LetSat/CarrierBoard_V2/092518_CARRIERV2.PNG

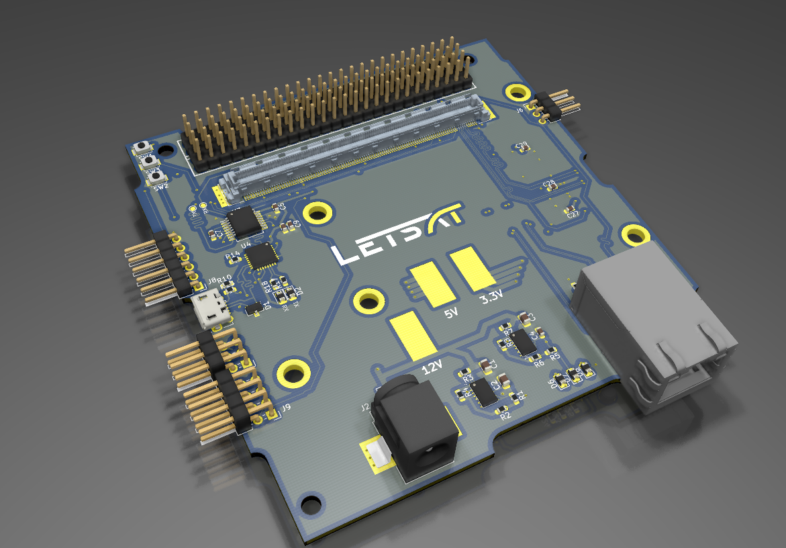
092518_CARRIERV2.PNG
