LetSat/CarrierBoard_V2/H1H2PSU.PNG

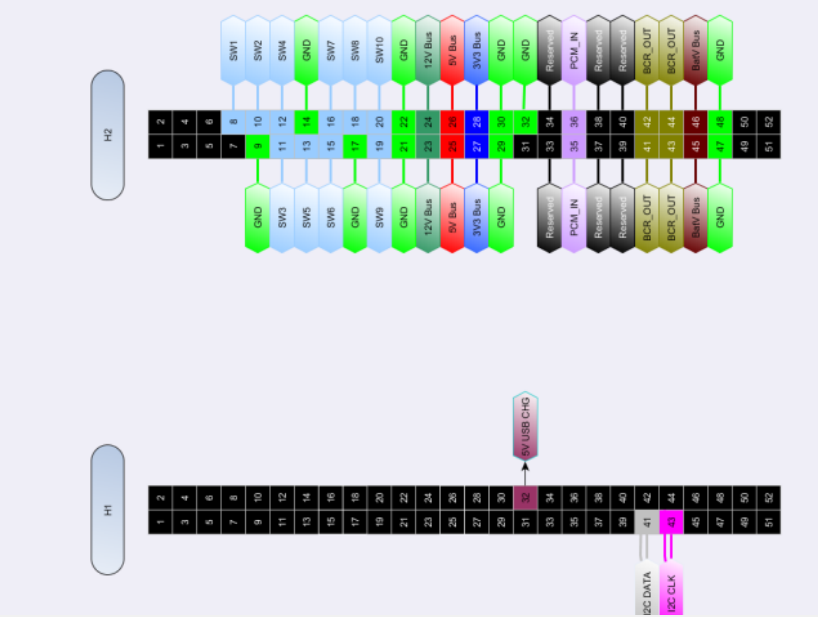
H1H2PSU.PNG
