LetSat/CarrierBoard_V2/Capture.PNG

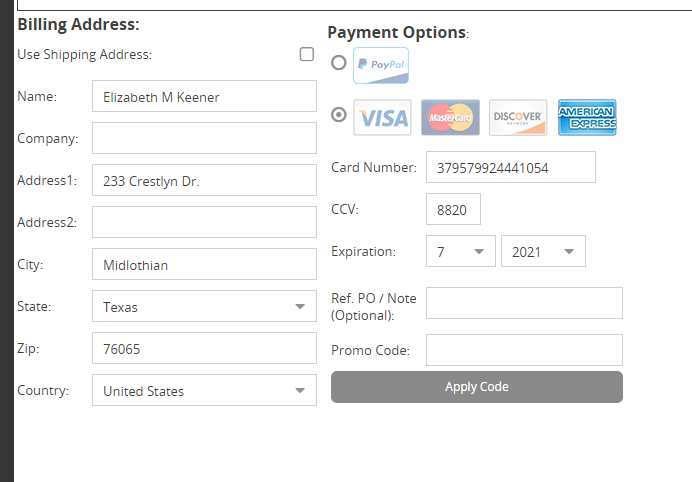
Capture.PNG
