LetSat/CarrierBoard_V2/H1H2FC.PNG

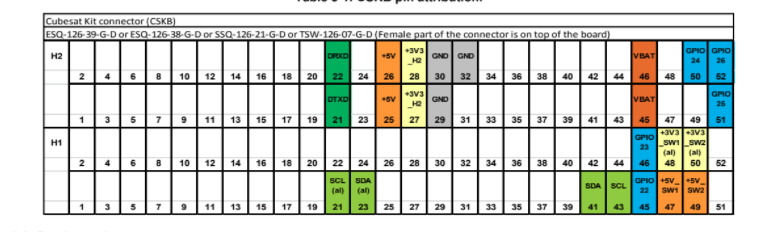
H1H2FC.PNG
