LetSat/CarrierBoard_V2/H1H2MAGT.PNG

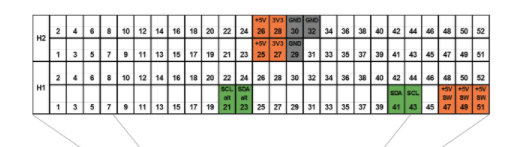
H1H2MAGT.PNG
