LetSat/CarrierBoard_V2/SPIBUSMcom.PNG

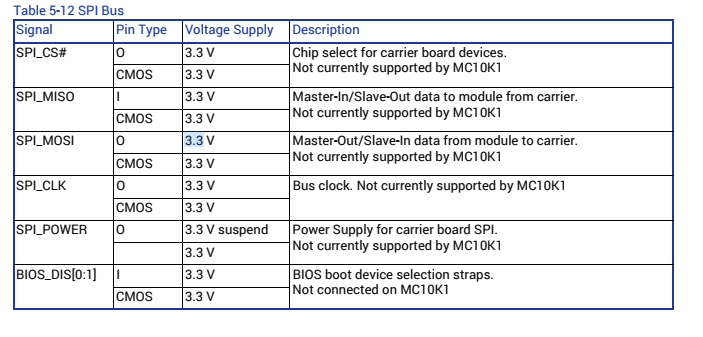
SPIBUSMcom.PNG
