LetSat/CarrierBoard_V2/Cart_Feb05_1015AM.xls

SHOPPING CART
This is not an invoice
05-Feb-18 10:15:46
 | Mouser # | Mfr. # | Manufacturer | Customer # | Description | RoHS | Lifecycle | Order Qty. | Price (USD) | Ext.: (USD)
1 | 530-SI-51009-F | SI-51009-F | Bel |  | Modular Connectors / Ethernet Connectors RJ45 Connector | RoHS Compliant |  | 1 | $5.70 | $5.70
2 | 755-BD67929EFV-E2 | BD67929EFV-E2 | ROHM Semiconductor |  | Motor / Motion / Ignition Controllers & Drivers NPN+NPN Driver Transistor | RoHS Compliant |  | 2 | $2.98 | $5.96
3 | 710-9774010151R | 9774010151R | Wurth Electronics |  | Standoffs & Spacers WA-SMSI SMT Steel M2.5 Intrnl NonStop | RoHS Compliant |  | 12 | $1.03 | $12.36
4 | 534-24380 | 24380 | Keystone Electronics |  | Standoffs & Spacers 4.5 HEX 5.0mm BRS | RoHS Compliant |  | 10 | $0.43 | $4.30
5 | 534-24381 | 24381 | Keystone Electronics |  | Standoffs & Spacers 4.5 HEX 6.0mm BRS | RoHS Compliant |  | 10 | $0.37 | $3.70
By submitting your order you agree to these terms and conditions. (https://www.mouser.com/saleterms) |  |  |  |  |  |  |  |  | Merchandise Total: | $32.02
Prices are reflected at the date and time shown. |  |  |  |  |  |  |  |  | Shipping Charge: | Estimate
 |  |  |  |  |  |  |  |  | Backorder Shipping: | Estimate
