LetSat/CarrierBoard_V2/CUI_PJ-036AH-SMT-TR.step

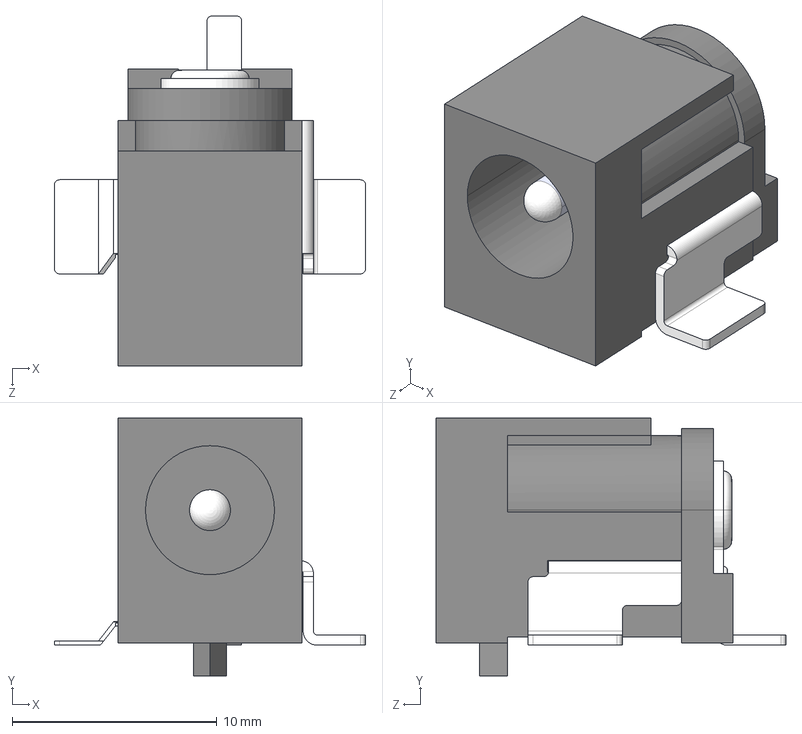
[picture p7: CAD file, 2018-09-25]
CUI_PJ-036AH-SMT-TR.step
15.2 x 12.6 x 17.1 mm
