LetSat/CarrierBoard_V2/ARJE-0034.STEP

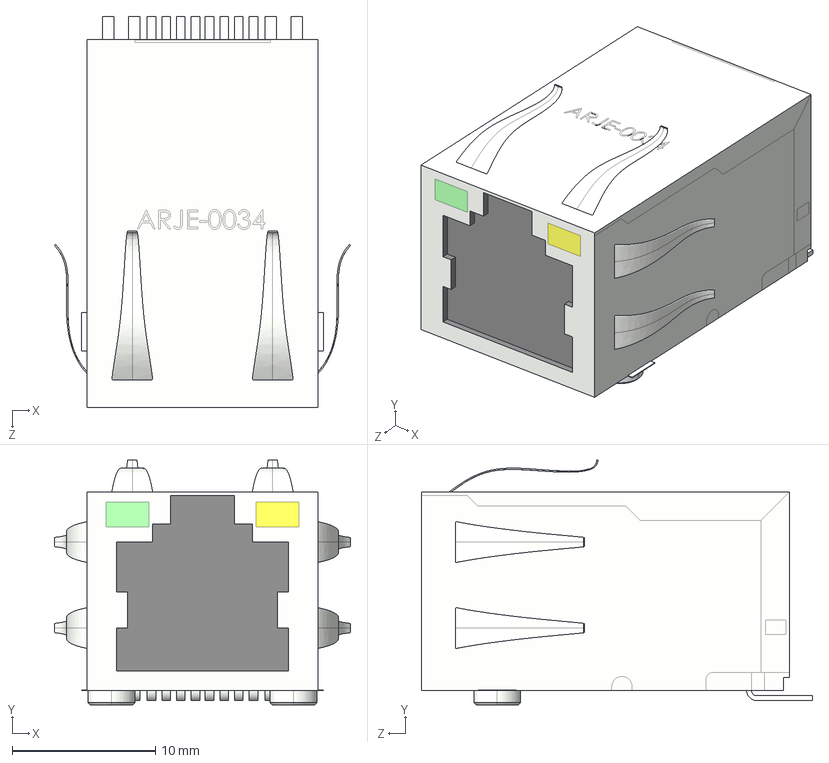
[picture p8: CAD file, 2018-09-25]
ARJE-0034.STEP
20.7 x 17.1 x 27.3 mm
