LetSat/CarrierBoard_V2/Carrier-Board.step

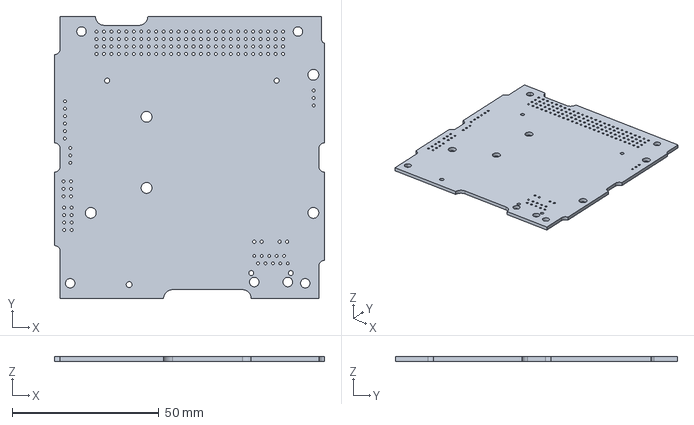
[picture p9: CAD file, 2018-09-14]
Carrier-Board.step
92.0 x 96.0 x 1.60 mm
