LetSat/CarrierBoard_V2/Part1.DXF

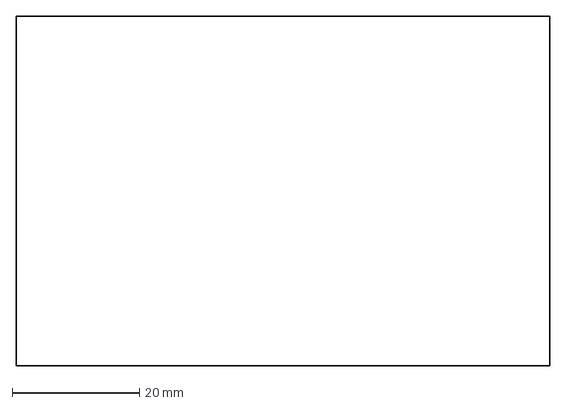
[picture p10: CAD file, 2018-09-14]
Part1.DXF
84.0 x 55.0 mm
