LetSat/CarrierBoard_V2/480251190.stp

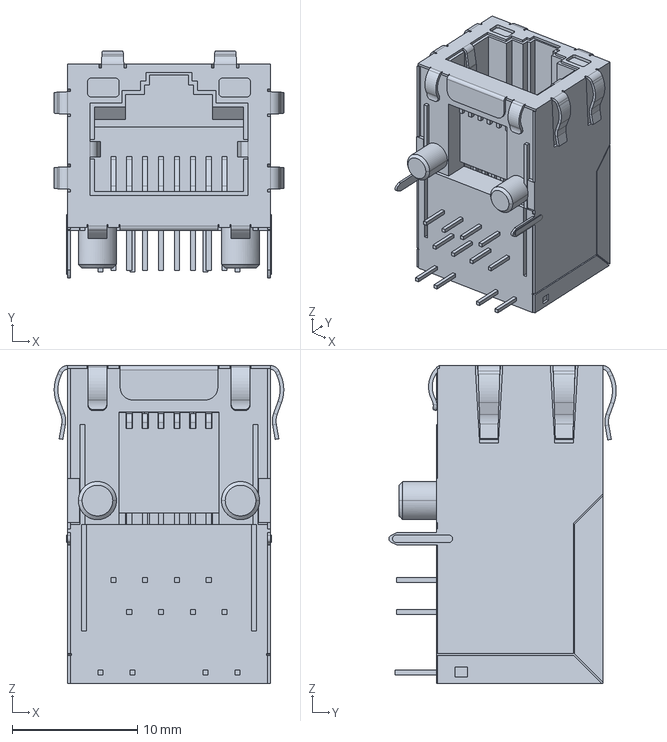
[picture p11: CAD file, 2018-09-25]
480251190.stp
18.3 x 18.2 x 25.4 mm
