LetSat/CarrierBoard_V2/Carrier-Board.kicad_pcb

## KiCad design Carrier-Board.kicad_pcb (2018-09-25)

Schematic: Carrier-Board.sch

Parts:
C1, C3: 10uF; C_0805_2012Metric
C2: 22uF; C_0805_2012Metric
C4: 22uF; C_0603_1608Metric
C5, C6, C10, C27, C28, C29: .1uF; C_0603_1608Metric
C7: 47nF; C_0603_1608Metric
C8, C11, C12: .33uF; C_0603_1608Metric
C9: 4.7uF; C_0603_1608Metric
D1: PESD12VL2BT,215; D_SOT-23_NKA
D2, D3, D6, D7, D8: LED; D_0805_2012Metric
D5: D_Zener 9V; D_SOD-323
G1: LOGO; LetSat_Logo_440
J1: CONN_3-6318491-6; ComExpressMini10
J2: Conn_01x0; Barrel_Jack_CUI_PJ-036AH-SMT
J3, J5: Conn_02x26_Odd_Even; ESQ-126-XX-X-D
J4: SI-51009-F; Manufacturer_Part_Number SI-51009-F
J6: Conn_01x03_Male; Pin_Header_Angled_1x03_Pitch2.54mm
J7: Conn_01x03_Male; TestPoint_Pad_D3.0mm
J8: Conn_01x06_Male; Pin_Header_Angled_1x06_Pitch2.54mm
J9: Conn_02x04_Odd_Even; Pin_Header_Angled_2x04_Pitch2.54mm
J10: Conn_02x03_Odd_Even; Pin_Header_Angled_2x03_Pitch2.54mm
J11: USB_B_Micro; USB_Micro-B_Molex-105017-0001
R1, R5: 160k; R_0603_1608Metric
R2: 30.1k; R_0603_1608Metric
R3, R7: 100k; R_0603_1608Metric
R4: 63.4k; R_0603_1608Metric
R6: 51k; R_0603_1608Metric
R8: 56k; R_0603_1608Metric
R9, R16, R23: 330; R_0603_1608Metric
R10, R11, R12, R13, R14: 10K; R_0603_1608Metric
R15: 4.7K; R_0603_1608Metric
R17, R18: 200; R_0603_1608Metric
R24: 180; R_0603_1608Metric
R25: 1k; R_0603_1608Metric
R32: 0; R_0603_1608Metric
SW1, SW2, SW3: SW_Push; SW_SPST_B3U-1000P
U1, U2: MPM3620; QFN-20
U3: MAX3221; SSOP-16_5.3x6.2mm_Pitch0.65mm
U4: FT232RQ; QFN50P500X500X100-33N
U9: MSATA-Socket; mpcie-socket

Connections:
+3.3V: C4.1, C27.1, C28.1, C29.1, D7.2 (A), J10.2, R5.1, U2.7, U2.8, U2.9, U9.2, U9.24, U9.39, U9.41, U9.52
GBE0_CTREF(GND): C1.2, C2.2, C3.2, C4.2, C5.2, C6.2, C9.2, C10.2, C11.2, C12.2, C27.2, C28.2, C29.2, D1.3, J1.1, J1.11, J1.14, J1.21, J1.31, J1.41, J1.51, J1.57, J1.60, J1.66, J1.70, J1.80, J1.90, J1.100, J1.110, J1.111, J1.121, J1.131, J1.141, J1.151, J1.161, J1.170, J1.180, J1.190, J1.200, J1.210, J1.220, J2.2, J4.1, J4.6, J4.17, J4.18, J6.1, J8.6, J10.6, J11.5, J11.6, R9.1, R10.1, R16.1, R23.1, R24.1, R25.1, R32.2, SW1.1, SW2.1, SW3.1, U1.12, U1.13, U1.14, U2.12, U2.13, U2.14, U3.1, U3.12, U3.14, U4.4, U4.17, U4.20, U4.24, U4.26, U4.33, U9.4, U9.9, U9.15, U9.18, U9.21, U9.26, U9.27, U9.29, U9.34, U9.35, U9.37, U9.40, U9.50
GBE0_LINK100#: J1.4, J4.16
GBE0_LINK1000#: J1.5, J4.13
GBE0_MDI0+: J1.13, J4.2
GBE0_MDI0-: J1.12, J4.3
GBE0_MDI1+: J1.10, J4.4
GBE0_MDI1-: J1.9, J4.5
GBE0_MDI2+: J1.7, J4.7
GBE0_MDI2-: J1.6, J4.8
GBE0_MDI3+: J1.3, J4.9
GBE0_MDI3-: J1.2, J4.10
GNDA: R2.2, R4.2, R6.2, R8.2, U1.3, U2.3
GPI0: J1.54, J9.1
GPI1: J1.63, J9.3
GPI2: J1.67, J9.5
GPI3: J1.85, J9.7
GPO0: J1.93, J9.2
GPO1: J1.164, J9.4
GPO2: J1.167, J9.6
GPO3: J1.173, J9.8
I2C_CK: J1.143, J6.3
I2C_DAT: J1.144, J6.2
unnamed: C7.1, U3.2
unnamed: C7.2, U3.4
unnamed: C8.1, U3.5
unnamed: C8.2, U3.6
unnamed: C10.1, U4.16
unnamed: C11.1, U3.3
unnamed: C12.1, U3.7
unnamed: D1.1, J11.2, U4.15
unnamed: D1.2, J11.3, U4.14
unnamed: D2.1 (K), R17.1
unnamed: D3.1 (K), R18.1
unnamed: D5.2 (A), D6.2 (A)
unnamed: D6.1 (K), R24.2
unnamed: D7.1 (K), R23.2
unnamed: D8.1 (K), R25.2
unnamed: J4.14, R16.2
unnamed: J4.15, R9.2
unnamed: J11.1, R15.1
unnamed: R1.2, R2.1, U1.1
unnamed: R3.2, U1.17
unnamed: R4.1, U1.18
unnamed: R5.2, R6.1, U2.1
unnamed: R7.2, U2.17
unnamed: R8.1, U2.18
unnamed: R14.2, U4.10
unnamed: R17.2, U4.22
unnamed: R18.2, U4.21
unnamed: R32.1, U9.51
PWRBTNn: J1.122, J8.5, R11.1, SW1.2
PWR_OK: J1.134, J8.2
RXD: U3.9, U4.2
Reset#: R10.2, R15.2, U4.18
SATA0_RX+: J1.19, U9.23
SATA0_RX-: J1.20, U9.25
SATA0_TX+: J1.16, U9.33
SATA0_TX-: J1.17, U9.31
SATA_ACTn: J1.28, U9.49
SLEEPn: J1.213, J8.1
SPI_CLK: J1.94, J10.3
SPI_CS#: J1.97, J10.5
SPI_MISO: J1.92, J10.1
SPI_MOSI: J1.95, J10.4
SYS_RESETn: J1.159, J8.4, R12.2, SW2.2
TXD: U3.11, U4.30
WAKE1n: J1.177, J8.3, R13.2, SW3.2
mCOM_5V_SBY: C2.1, C5.1, C6.1, C9.1, D2.2 (A), D3.2 (A), D8.2 (A), J1.194, J1.195, J1.196, J1.197, R1.1, R11.2, R12.1, R13.1, R14.1, U1.7, U1.8, U1.9, U3.15, U3.16, U4.1, U4.19
mCOM_12V: C1.1, C3.1, D5.1 (K), J1.104, J1.105, J1.106, J1.107, J1.108, J1.109, J1.214, J1.215, J1.216, J1.217, J1.218, J1.219, J2.1, R3.1, R7.1, U1.16, U2.16
mCOM_RX: J1.99, U3.13
mCOM_TX: J1.98, U3.8

Notes on the sheet:
Break out
LED Indicators
3V3
12V
5V SBY
Voltage Supply
LetSat-1 Carrier Prototype
Spring 2018
Sata Connector
mCOMTK1
I2C
Rs232
SPI
GPIO
MISC SHIT
PC104
Pixie Wranglers: Prabodh Jhaveri Chandler Griscom
polarized +
polarized -
Ethernet
USB to RS232

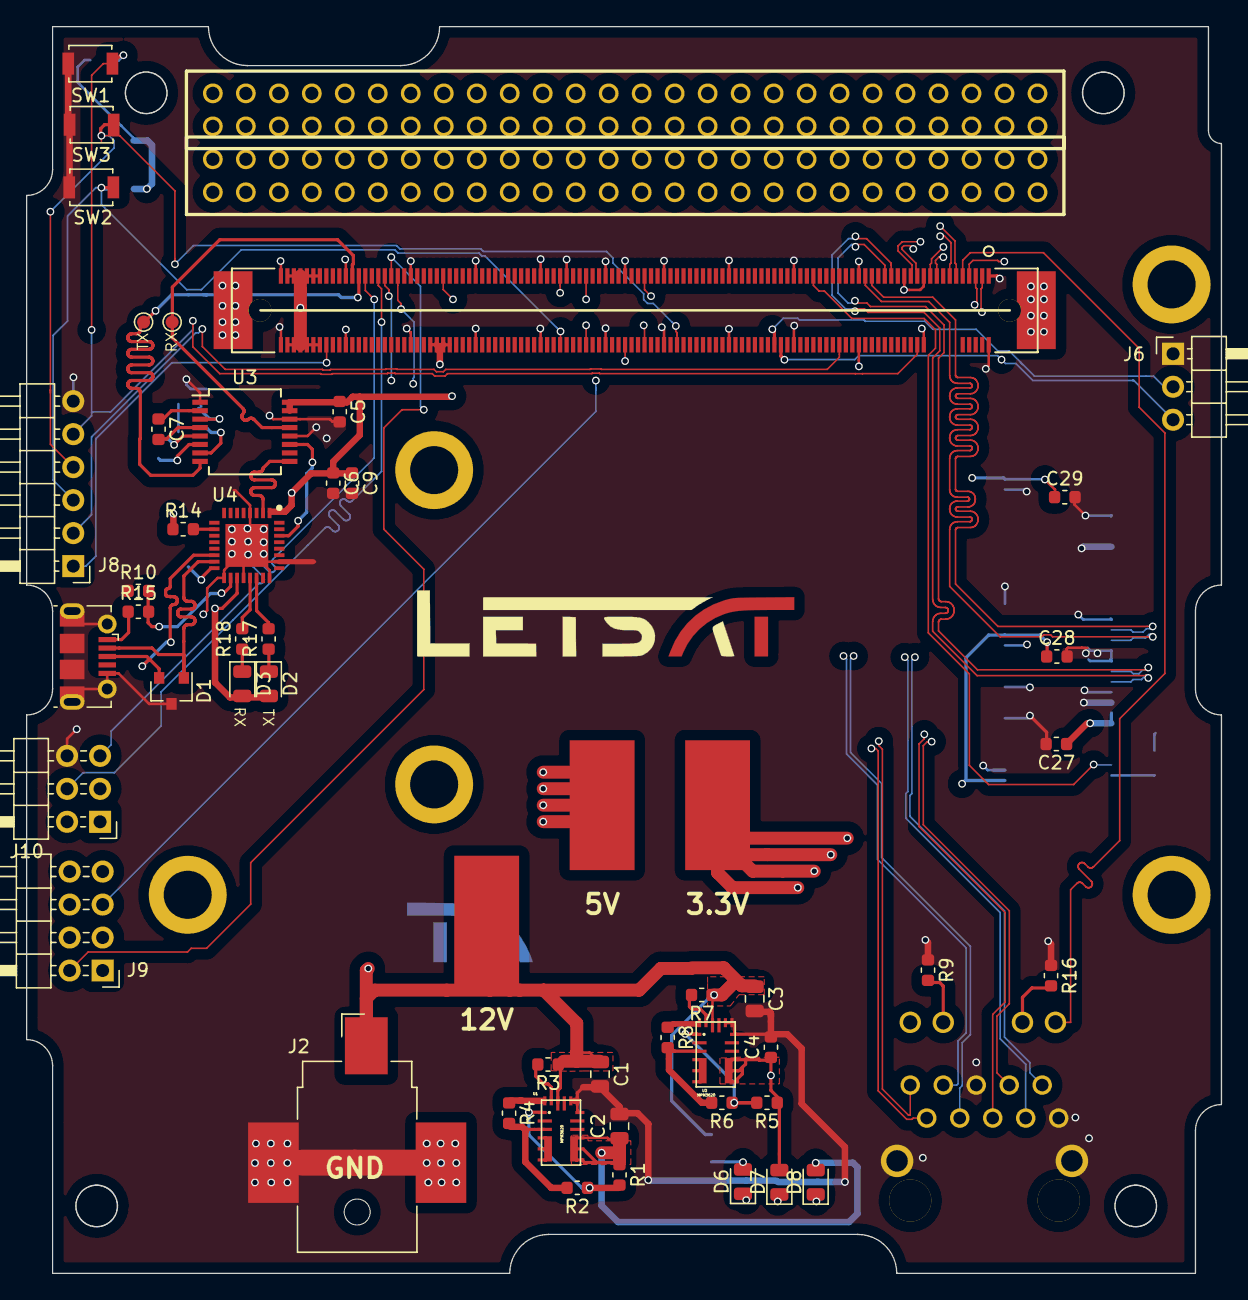
[picture p12: board Carrier-Board.kicad_pcb from above]

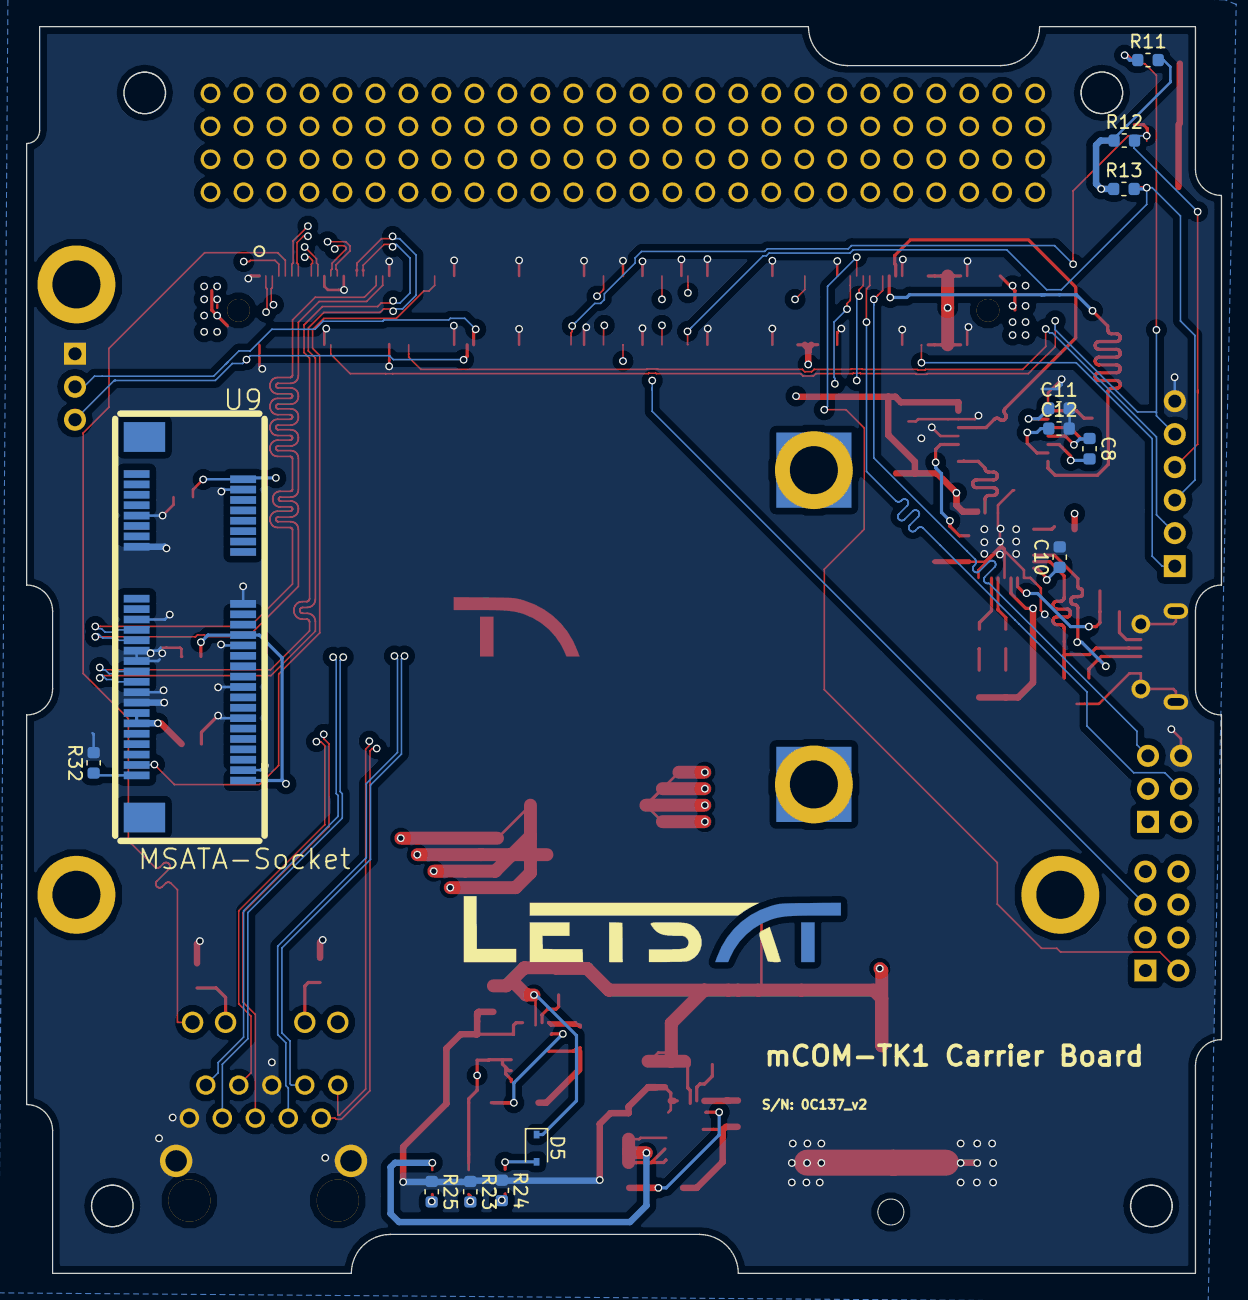
[picture p13: board Carrier-Board.kicad_pcb from below]

Board: 4 copper layers, 92.0 x 96.0 mm, 69 parts (14 on the bottom side), 72 nets.

Other parts of the board:
G1#2: LOGO; LetSat_Logo_440
m1, m1#2, m1#3, m1#4, m2: MountingHole_2.7mm_M2.5_Pad
