LetSat/CarrierBoard_V2/(commit log)

2018-09-14 Master Commit
    [Carrier-Board-2018-09-08-16-57-46.sch, Carrier-Board-2018-09-11-15-57-00.sch, Carrier-Board-2018-09-14-10-33-25.sch, Carrier-Board-2018-09-14-10-33-46.sch, Carrier-Board-2018-09-14-10-34-07.sch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]
2018-09-19 lib stuff'
    [Carrier-Board.sch]
2018-09-19 added usb
    [Carrier-Board.sch, _saved_Carrier-Board.sch]
2018-09-21 Finished Schematic for RS232 to USB
    [Carrier-Board.sch]
2018-09-22 Finished USB>rs232
    Verify needed
    [Carrier-Board.kicad_pcb, _saved_Carrier-Board.sch]
2018-09-22 changed serial number
    [Carrier-Board.kicad_pcb]
2018-09-23 Fix broken libraries
    [Carrier-Board.sch]
2018-09-23 Change footprint sizes
    [Carrier-Board.kicad_pcb, Carrier-Board.sch]
2018-09-25 added 3d models
    [480251190.stp, ARJE-0034.STEP, Carrier-Board.kicad_pcb, _saved_Carrier-Board.sch]
